fitzterra/uCNC-Frame/Servo-SG90-Dimensions.jpg

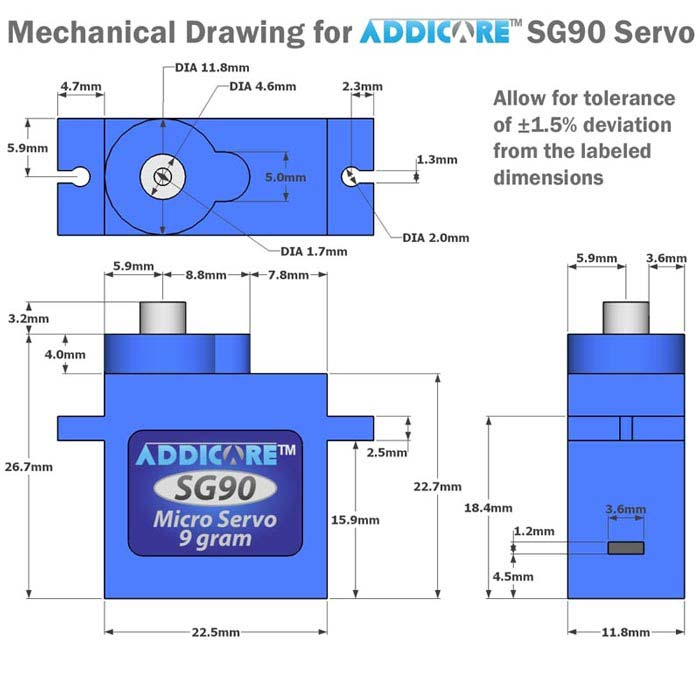
Servo-SG90-Dimensions.jpg
