fitzterra/uCNC-Frame/Servo-SG90-Dimensions-2.jpg

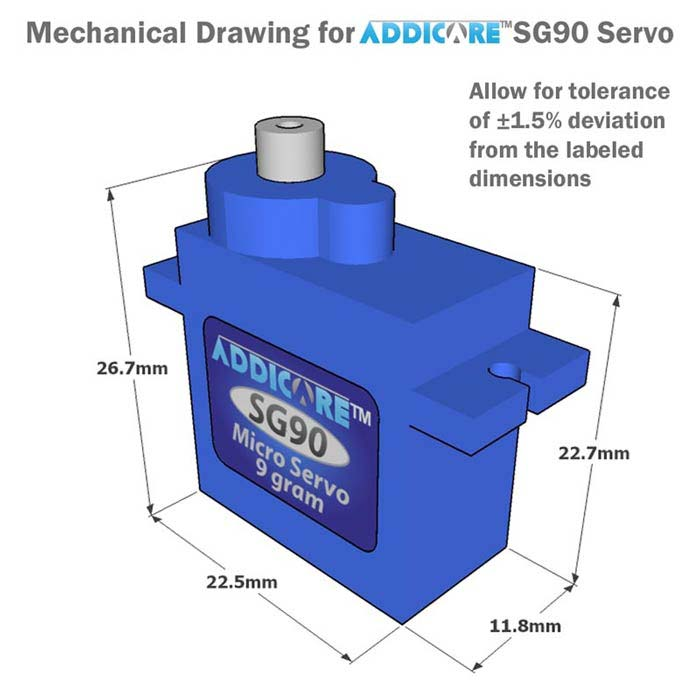
Servo-SG90-Dimensions-2.jpg
