fitzterra/uCNC-Frame/STL/PenTool+ZCar+Pinion.stl

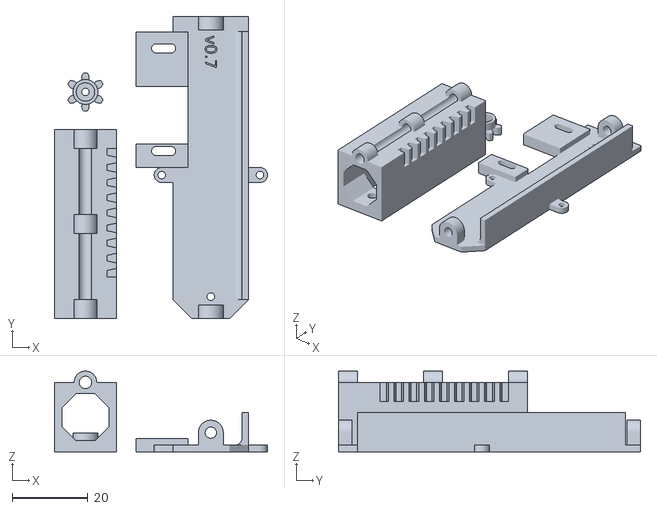
[picture p3: CAD file, 2015-05-19]
STL/PenTool+ZCar+Pinion.stl
56.4 x 80.0 x 21.4
