fitzterra/uCNC-Frame/STL/PenLift.stl

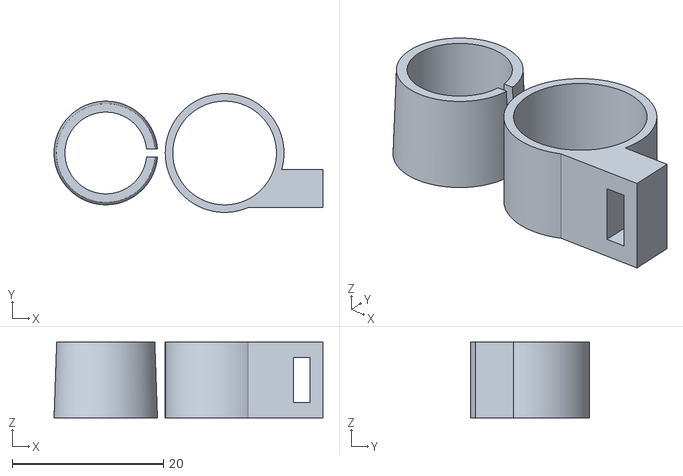
[picture p4: CAD file, 2015-05-12]
STL/PenLift.stl
35.5 x 15.7 x 10.0
