fitzterra/uCNC-Frame/STL/PenTool.stl

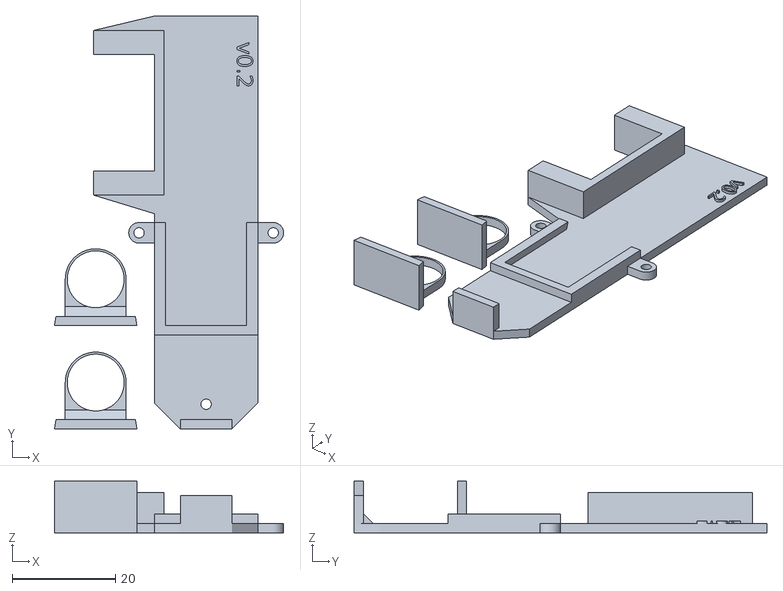
[picture p5: CAD file, 2015-05-12]
STL/PenTool.stl
44.4 x 80.0 x 10.0
