fitzterra/uCNC-Frame/STL/X-Carraige.stl

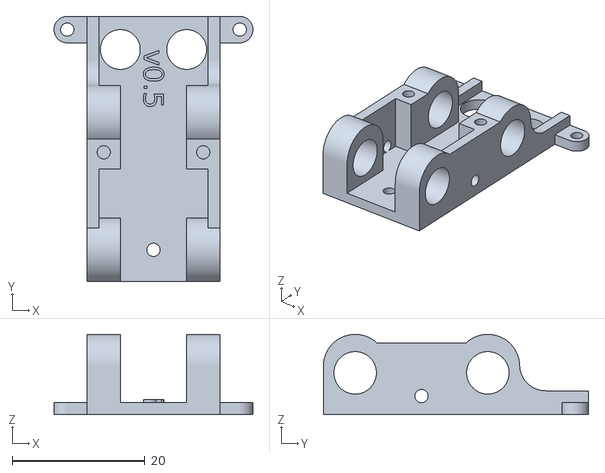
[picture p6: CAD file, 2015-05-12]
STL/X-Carraige.stl
30.0 x 40.0 x 12.1
