fitzterra/uCNC-Frame/STL/PenLoops.stl

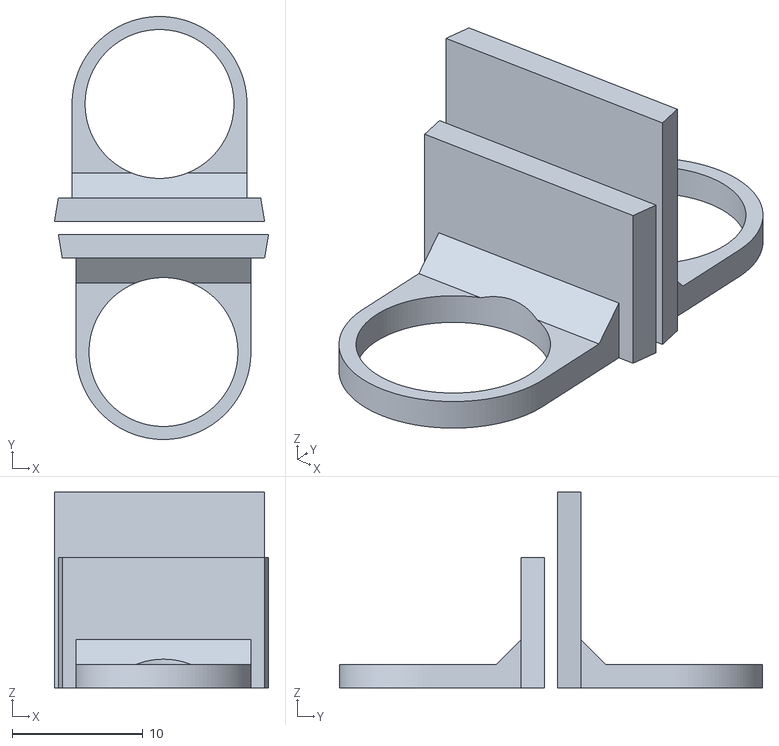
[picture p7: CAD file, 2015-05-12]
STL/PenLoops.stl
16.4 x 32.4 x 15.0
