fitzterra/uCNC-Frame/STL/MotorCoupling-8mm.stl

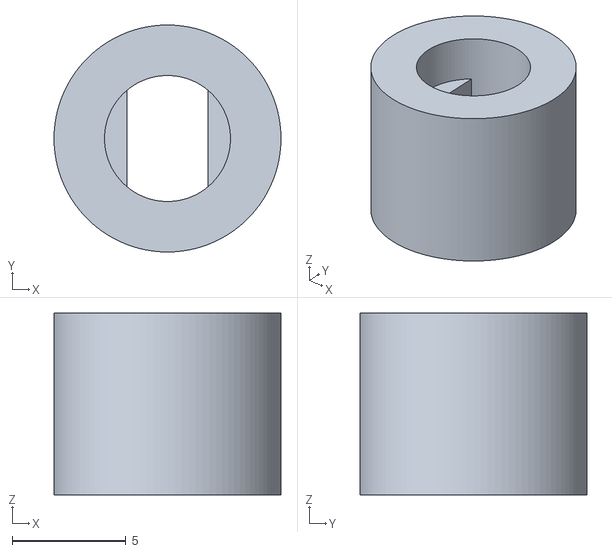
[picture p8: CAD file, 2015-05-01]
STL/MotorCoupling-8mm.stl
10.0 x 10.0 x 8.00
