fitzterra/uCNC-Frame/STL/MotorCoupling.stl

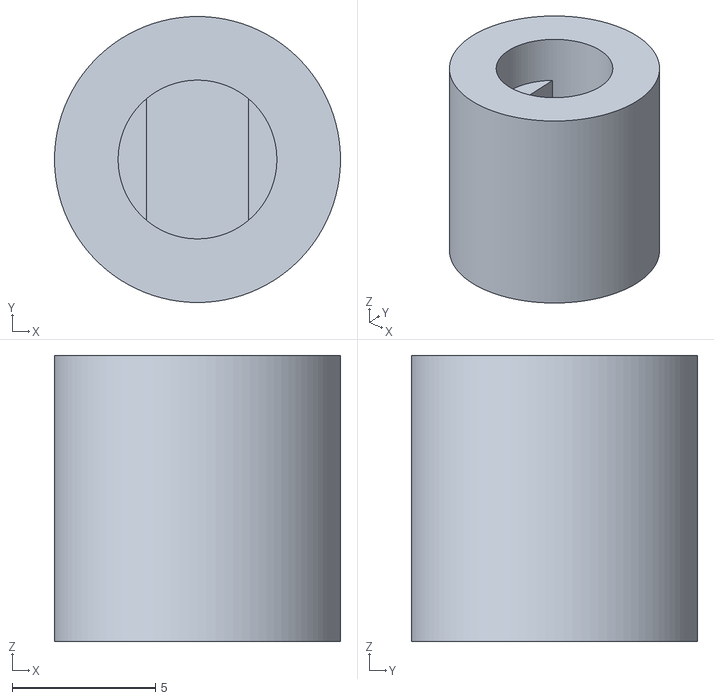
[picture p9: CAD file, 2015-04-27]
STL/MotorCoupling.stl
10.0 x 10.0 x 10.0
