fitzterra/uCNC-Frame/STL/X-Bridge-Motor-Side.stl

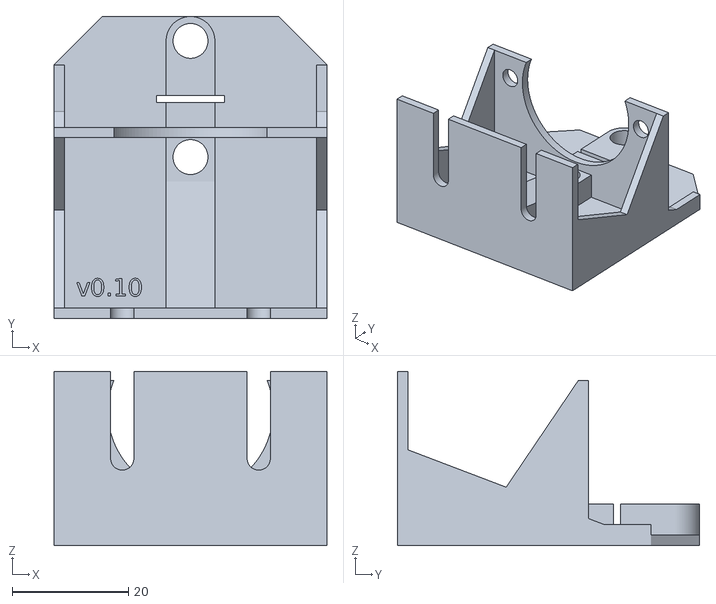
[picture p10: CAD file, 2015-04-25]
STL/X-Bridge-Motor-Side.stl
47.0 x 52.0 x 30.0
