fitzterra/uCNC-Frame/STL/X-Bridge-Bearing-Side.stl

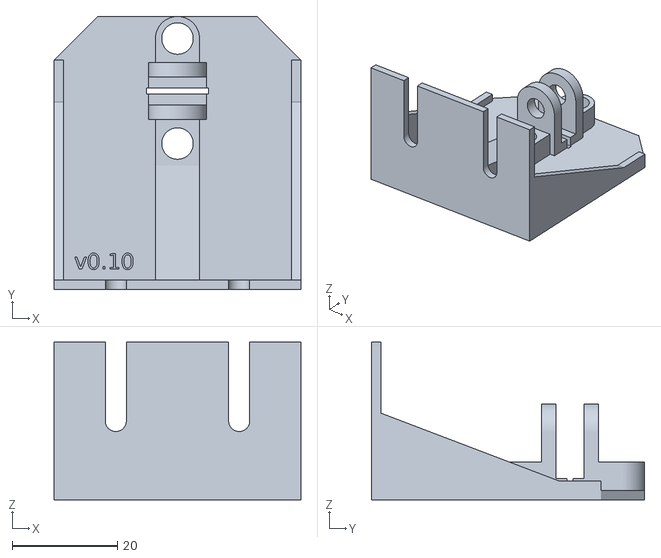
[picture p11: CAD file, 2015-04-25]
STL/X-Bridge-Bearing-Side.stl
47.0 x 52.0 x 30.0
