fitzterra/uCNC-Frame/X-Carraige.scad

/**
 * X Carraige
 **/

//-----------------------------------
// Draw/print Control

// Set to true to draw for printing
print = true;

// Mounting option? One of:
// "mag" for magnet mounts
// "M2" for M2 screw mounting
mount = "M2";
//------------------------------------

// Version number for X Carraige
_version = "v0.6";

include <Configuration.scad>;
use <ToolsLib.scad>;

/**
 * Module to draw one rotated S shape spring.
 *
 * @param w: Spring width
 * @param h: Spring height
 * @param d: Spring depth (Z axis)
 * @param st: Spring thickness
 **/
module Spring(w, h, d, st) {
    // Circle diameter
    cd = w/2+st/2;

    // Circles center
    c = h/2;

    // Two half circles
    for(xy=[[cd/2,-cd/2], [w-cd/2,0]]) {
        translate([xy[0], c, 0])
            difference() {
                cylinder(h=d, d=cd);
                translate([0, 0, -0.1])
                    cylinder(h=d+0.2, d=cd-st*2);
                translate([-cd/2, xy[1], -0.1])
                    cube([cd, cd/2, d+0.2]);
            }
    }
    // Legs
    cube([st, h/2, d]);
    translate([w-st, h/2, 0])
        cube([st, h/2, d]);
}

/**
 * Draws the spring box.
 *
 * @param w: Outer width of the box
 * @param h: Outer height of the box
 * @param d: Depth of the box
 * @param wt: Wall thickness of the box (only has upper and lower walls)
 * @param st: Thickness of each spring
 * @param ss: Spacing between springs
 * @param ns: Number of springs
 **/
module SpringBox(w, h, d, wt, st, ss, ns=4) {

    // Calculate the width of one spring. Note springs form the left and right
    // edges since there are no walls on the sides.
    sw = (w - (ns-1)*ss) / ns;

    // Top and bottom walls
    cube([w, wt, d]);
    translate([0, h-wt, 0])
        cube([w, wt, d]);

    // The springs
    for (s=[0:ns-1]) {
        // We do rotation, etc if printing the 2nd half of the spring
        swop = s >= ns/2;
        // Calculate offset for each spring
        o = s*(sw+ss);
        // Rotation
        rot = [0, swop ? 180 : 0, 0];
        // Translation
        trans = [o+(swop ? sw : 0), 0, swop ? d : 0];
        translate(trans) {
            rotate(rot)
                Spring(sw, h, d, st);
        }
    }

}

/**
 * X Carriage
 *
 * @param h: Height
 * @param w: Width
 * @param f: Length of foot piece
 * @param t: Wall thickness
 * @param rd: Diameter of rail rods
 * @param rcd: Rails center distance - distance center-to-center
 * @param bw: Bushing width
 * @param mag: If supplied, caveties for magnets of this size will be added to be
 *        used as a means of attaching to the base. The value should be a vector
 *        of [d, t] where d is the magnet diameter (additional clearance will be
 *        added), and t is the magnet thickness. One cavety bottom center, and
 *        one each top left and right will be added.
 *
 **/
module XCarraige(w, h, t, rd, rcd, bw, mag="") {
    // We use the wall thickness as base for the rail bushings outer diameter.
    b_od = rd + t*2;

    // Preset the diameter for the drive wire holes
    dwh = XB_dwd+1;
    
    // The carraige depth is determined by either the distance between the drive
    // wire holes, or the bushings outer diameter.
    drvWrDist = dwh + XC_dwd;
    // Now determine the carriage depth. Note that this depth is EXCLUDING the
    // flace plate thickness. Also note that we want to add 1mm clearing if the
    // drive wire distance determines the depth or else the one drive wire hole
    // will be right on the edge. Due to this, the center for the depth must also
    // be calculated and remebered separately.
    cd = (drvWrDist > b_od) ? drvWrDist-dwh : b_od;
    cdc = (drvWrDist > b_od) ? drvWrDist/2 : b_od/2;
    echo("drvWrDist:", drvWrDist);
    echo("b_od:", b_od);
    echo("cd:", cd);
    echo("cdc:", cdc);

    // Precalculate the spring box params because we use it in multiple places.
    // Since the spring box may not have enough height in the original size, we
    // allow it to slightly extend into the lower bushings. This value sets by
    // how much it may be extended.
    sb_ext = 1.2;
    // The final spring box height
    sb_h = rcd/2-dwh/2-b_od/2+sb_ext;
    // The depth
    sb_d = t+cd;
    // The wall thickness
    sb_wt = 0.8;
    // The spring thickness
    sb_st = 0.5;
    // The spacing between springs
    sb_ss = 1;
    // Number of springs
    sb_ns = 4;

    // Mounting tabs are either for magnets or M2 screws. We calculate the
    // diameters and sizes here to be used in multiple places.
    tabID = mag=="" ? 2 : mag[0]+0.4;  // Inner diameter. Extra clearence for mag
    tabOD = tabID + 2;  // Outer diameter - rim width - must be doubled
    tabNeck = 1;        // Extra space for tab neck
    mh_d = mag=="" ? t+2 : mag[1];    // Mount hole depth
    mh_z = mag=="" ? -1 : 0.6;        // Mount hole Z offset

    difference() {
        union() {
            // First the face
            cube([w, h, t]);

            // Draw the side walls. Side walls does not go all the way to the top, but
            // stops at the top of the top bushing outer wall.
            for(x=[0, w-t]) {
                // The side wall
                translate([x, b_od/2, t])
                    cube([t, rcd, cd]);
                // The lip on the upper part, and rounded gusset for smartness
                translate([x, rcd+b_od, t]) {
                    cube([t, h-rcd-b_od, t]);
                    difference() {
                        cube([t, (b_od-t)/2, (b_od-t)/2+t]);
                        translate([t+1, (b_od-t)/2, (b_od-t)/2+t])
                            rotate([0, -90, 0])
                               cylinder(h=t+2, d=b_od-t);
                    }
                }
            }

            // Bushings. Define the bushing translate positions
            btp = [
                    [0, 0],     // Bottom left, x and y
                    [w-bw, 0],  // Bottom right, x and y
                    [0, rcd],  // Top left, x and y
                    [w-bw, rcd],  // Bottom left, x and y
                ];
            for(bp=btp) {
                translate([bp[0], bp[1], t])
                    cube([bw, b_od, cdc]);
                translate([bp[0], bp[1]+b_od/2, t+cdc])
                    rotate([0, 90, 0])
                        cylinder(h=bw, d=b_od);
            }

            // 3mm blocks just below the top bushings. We'll put 2mm x 5mm deep
            // holes in them later. This is so you can use an M2 screw to hold
            // the drive wires secure after threading the wire.
            for(x=[0, w-XC_bw]) {
                translate([x, rcd-3, t])
                    cube([XC_bw, 3+b_od/2, cd]); 
            }

            // Top mounting tabs.
            // Left tab
            translate([-tabOD/2-tabNeck, XC_h-tabOD/2, 0]) {
                cylinder(h=t, d=tabOD);
                translate([0, -tabOD/2, 0])
                    cube([tabOD/2+tabNeck, tabOD, t]);
            }
            // Right tab
            translate([w+tabOD/2+tabNeck, XC_h-tabOD/2, 0]) {
                cylinder(h=t, d=tabOD);
                translate([-tabNeck-tabOD/2, -tabOD/2, 0])
                    cube([tabOD/2+tabNeck, tabOD, t]);
            }
        }

        // Stuff we want to remove goes here.
        // Rail holes
        for (y=[rd/2+t, rd/2+t+rcd]) {
            translate([-1, y, t+cd/2])
                rotate([0, 90, 0])
                    cylinder(h=w*1.3, d=rd+XC_rhc);
        }
        // Drive wire holes ...
        for (z=[t+dwh/2, t+dwh/2+XC_dwd]) {
            translate([-1, (b_od+rcd)/2, z])
                rotate([0, 90, 0])
                    cylinder(h=w*1.3, d=dwh);
        }
        // 2mm x 5mm deep holes in the blocks provided for securing the drive
        // wire ends in the carraige
        for(x=[0, w-XC_bw]) {
            translate([x+XC_bw/2, rcd-0.5, t+cd-5])
                cylinder(d=2, h=6);
        }

        // The spring box cutout if needed
        if(XC_springs==true) 
            translate([-1, b_od-sb_ext+0.1, -1])
                cube([w+2, sb_h-0.2, sb_d+2]);

        // The two holes at the top like the original
        for (x=[w/4, w-w/4]) {
            translate([x, h-w/4, -0.1])
                cylinder(h=t+0.2, d=rd);
        }
        // Mounting holes if not using magnets, else magnet indents.
        // Bottom center - we use the tab OD to determine the center
        translate([w/2, t+2+tabOD/2, mh_z])
            cylinder(h=mh_d, d=tabID);
        // Left tab
        translate([-1-tabOD/2, XC_h-tabOD/2, mh_z])
            cylinder(h=mh_d, d=tabID);
        // Right tab
        translate([w+1+tabOD/2, XC_h-tabOD/2, mh_z])
            cylinder(h=mh_d, d=tabID);
    }

    // The spring box If needed
    if(XC_springs==true)
        translate([0, b_od-sb_ext, 0])
            SpringBox(w, sb_h, sb_d, sb_wt, sb_st, sb_ss, sb_ns);


    // The version number
    //translate([t+2, t+2, t+4])
    translate([w/2, h-5, t])
        rotate([0, 0, -90])
            Version(h=0.5, s=3, v=_version, valign="center");

}


XCarraige(XC_w, XC_h, XC_t, XC_rd, XC_rcd, XC_bw, mount=="mag" ? magSize : "");
