fitzterra/uCNC-Frame/(threads)

Thread 1 (2020-10-02):

Hey :)

fermino, 2020-10-02:
Just wanted to say a big thank you for this amazing work, I've been tweaking it a little bit to fit my needs (using 608zz bearings and a couple other things), and it's been super easy to work with it! (besides it's the first try for me using OpenSCAD hahaha).

I'm working on the forked repo if you want to take a look :)

Anyways, seriously, a big thank you for you!
Have an awesome day!

fitzterra, 2020-10-02:
Hey @fermino .

I'm very glad that you find this useful. I built an initial prototype that worked quite well, but then life got in the way and I had no more time to continue working on it.

I had a quick look at your fork, and it's looking good. Let me know when you have something working. I'd love to see it :+1:
