fitzterra/uCNC-Frame/(commit log)

2015-04-25 Initial commit
    First commit at v0.8 with only the X Bridges done so far.
    [ToolsLib.scad, X-Bridge-Bearing-Side.stl, X-Bridge-Motor-Side.stl, X-Bridges.scad, X-Bridges.stl]
2015-04-25 Improve X Bridge bearing mount
    Bearing mount now slightly thicker and larger to allow better
    printing.
    [X-Bridge-Bearing-Side.stl, X-Bridge-Motor-Side.stl, X-Bridges.scad, X-Bridges.stl]
2015-04-25 Decrease wall thickness
    Wall thickness decreas by 0.2mm and slicer settings changed in
    order to try get better print results.
    [X-Bridge-Bearing-Side.stl, X-Bridge-Motor-Side.stl, X-Bridges.scad]
2015-04-27 Add X Carraige, Motor Coupling and config file
    * Add a new configuration file that defines all parameters for the full
    plotter. All components can import this to get values for specific
    parameters.
    * Move X-Bridges parameters to config file.
    * Add new X-Carriage design.
    * Add new motor coupling for the 28BYJ-48 motor shaft
    * Allow vertical and horizontal placement to be specified for Version()
    module with defaults to center for both.
    [Configuration.scad, MotorCoupling.scad, MotorCoupling.stl, ToolsLib.scad, X-Bridges.scad, X-Carraige.scad, X-Carraige.stl]
2015-04-28 Improvements to X-Carriage
    * Add option to specify the motor/bearing drive sides width to determine
    position of drive wire holes in the carraige.
    * Side walls will be made to fit either the bushig outer diameter or
    distance between drive wire holes - which ever is greater. Although,
    if drive wire holes are larger, the side walls will be decreased so no
    holes oposite the face plate are created. This allows the wire on that
    side to run free and makes carraige less deep.
    * Add a block with 2mm hole that can be used to secure the srive wire
    ends with a screw into the carraige. No more trying to tie the ends
    down, and this should make it easier to adjust tension.
    * Springs can now o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
    [Configuration.scad, X-Carraige.scad, X-Carraige.stl]
2015-05-01 Modify motor coupling and new 8mm tall coupling.
    [MotorCoupling-8mm.stl]
2015-05-02 Add the Pen Tool design.
    * Add Pen Tool design based on original uCNC design, but with changes on
    how pen loops attach to the tool.
    * Add config options for, and code in ToolsLib.scad to draw a 9g micro
    servo.
    [Configuration.scad, PenTool.scad, ToolsLib.scad]
2015-05-04 Better Pentool slide and X Carraige mounts.
    * Wider sliders to fit full width.
    * Remove support ridges and one gusset for simplification and to make
    wider slider fit.
    * Add mounting tabs and mounting hole to attach to X Carraige. Either
    magnets or 2M screws can be used for mounting.
    Still have to make magnet/screw mounting a configurable option, and
    also add the mounting options to the X Carraige
    [Configuration.scad, PenTool.scad]
2015-05-12 New Pens file and lifter designs
    * Modify PenTool and X-Carraige mount options to either use magnets or
    M2 size screws.
    * Add new design pen lifter for use with servo horn - Not working too
    well, and will probably need a better design.
    * Add 9G size servo parameters sheets
    * Update servo parameters and added servo horn
    * Add new Pens scad with first pen : Artliner725
    [Configuration.scad, PenTool.scad, Pens.scad, ToolsLib.scad, X-Carraige.scad]
2015-05-12 Update and new STL files.
    [PenLift.stl, PenLoops.stl, PenTool.stl, X-Carraige.stl]
2015-05-17 New Z Carraige using rack and pinion for Z control.
    Modify PenTool for new servo position and new Z Carraige into which a
    pen can be mounted. Complete Z Carriage now moves up and down by sliding
    on a vertically mounted M3 shaft, and is driven by sevo via rack/pinion
    gears.
    The pen is mounted directly in the Z Carriage, but for the moment is not
    quick or easy to mount/remove. A better method should be designed to
    easily mount/umount pens.
    To create the gearing, the publicDomainGearV1.1 from
    http://www.thingiverse.com/thing:5505 is required.
    [Configuration.scad, PenTool.scad, ToolsLib.scad, X-Carraige.scad]
2015-05-17 Better Z Carraige design.
    * Remove full front face now but only leave top and bottom blocks for
    adding grubscrews to quickly insert/remove and secure many pen sizes.
    * Simplify server mounting to allow more room for adjustment.
    [Configuration.scad, PenTool.scad]
2015-05-19 Allow more servo adjustment
    * Allow more lateral movement for servo
    * Slightly reduce the overhang of the servo mount tabs
    * Lengthen the Z Carriage shaft
    * Update README
    [Configuration.scad, PenTool+ZCar+Pinion.stl, PenTool.scad]
2015-05-22 Add Y Axis Bridges
    * Add Y Bridges desing based on original uCNC designs
    * Config:
    - Add some more 28BYJ-48 motor dimensions needed for Y bridges
    - Add Y Bridges dimensions config
    * Tools Library:
    - Move base X Bridge module into X Bridges file where it belongs
    - Create new 28BYJ-48 motor module that draws motor and a semi
    parametric shaft coupling
    [Configuration.scad, ToolsLib.scad, X-Bridges.scad, Y-Bridges.scad]
2015-05-28 Add Y Carriage and Y Bed designs
    * Add configs and designs for Y Carraige and Y Bed
    * Allow setting options for modeling the Y Axis with all components,
    printing, or designing. THese options can apply to one component only,
    or to all of them.
    [Configuration.scad, Y-Bridges.scad]
